shobhitsinha04/battlebot/hardware/battlebot.kicad_pcb

## KiCad design hardware/battlebot.kicad_pcb (2026-09-28)

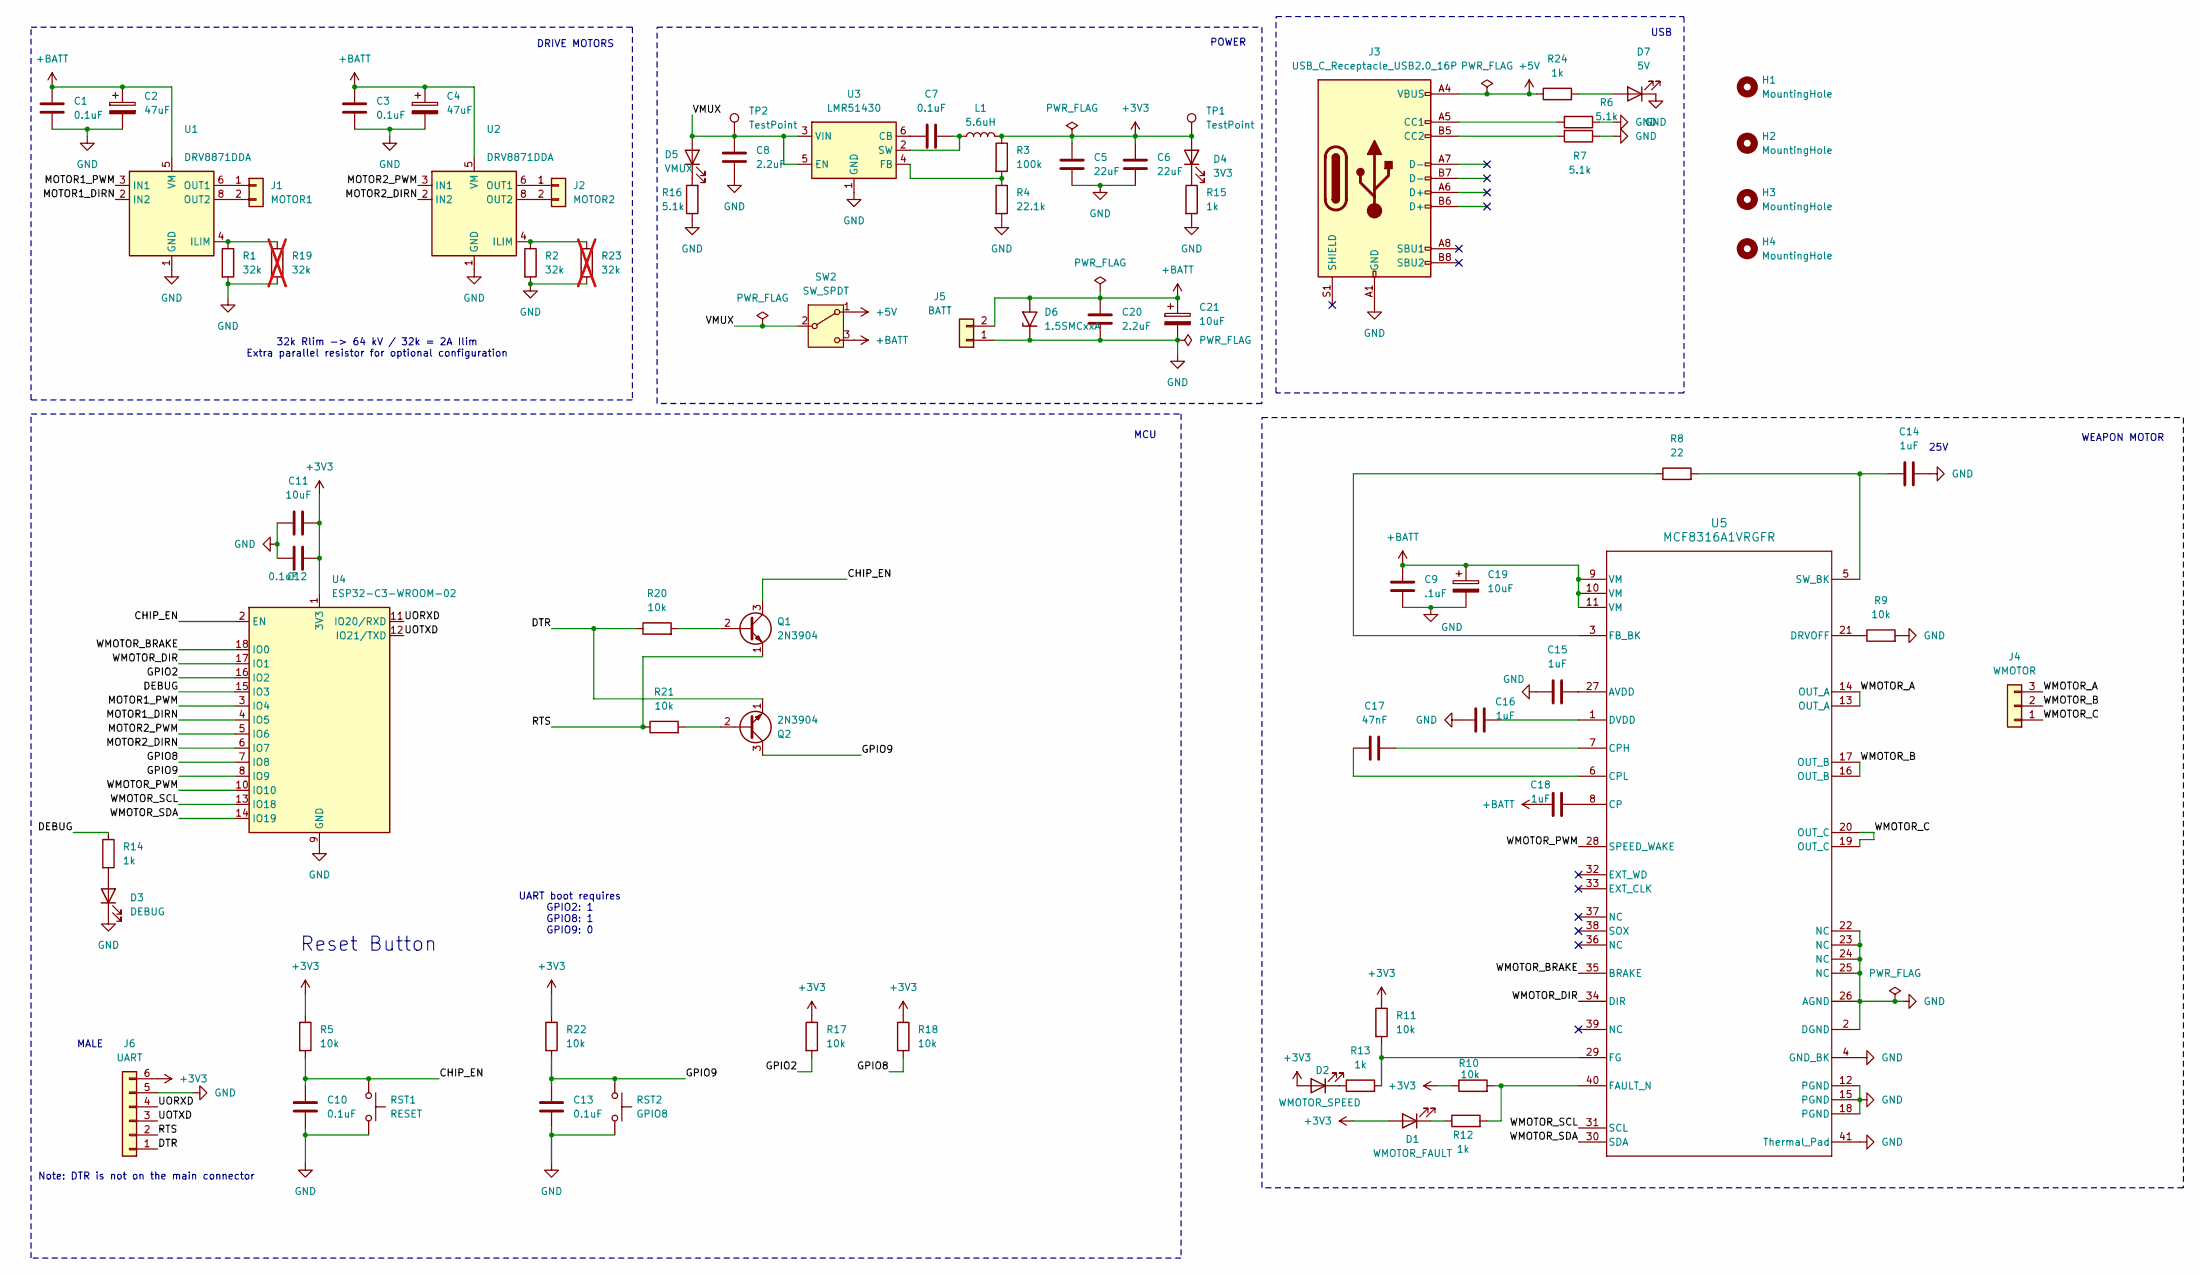
[picture p2: schematic battlebot.kicad_sch]

Parts:
C1, C3, C7, C10, C12, C13: 0.1uF; C_0805_2012Metric
C2, C4: 47uF; CP_Radial_D8.0mm_P5.00mm
C5, C6: 22uF; C_0805_2012Metric
C8, C20: 2.2uF; C_0805_2012Metric
C9: .1uF; C_0805_2012Metric
C11: 10uF; C_0805_2012Metric
C14, C15, C16, C18: 1uF; C_0805_2012Metric
C17: 47nF; C_0805_2012Metric
C19, C21: 10uF; CP_Radial_D8.0mm_P5.00mm
D1: WMOTOR_FAULT; C_0805_2012Metric
D2: WMOTOR_SPEED; C_0805_2012Metric
D3: DEBUG; C_0805_2012Metric
D4: 3V3; C_0805_2012Metric
D5: VMUX; C_0805_2012Metric
D6: 1.5SMCxxA; D_SMC
D7: 5V; C_0805_2012Metric
H1, H2, H3, H4: MountingHole; MountingHole_2.2mm_M2
J1: MOTOR1; PinSocket_1x02_P2.54mm_Vertical
J2: MOTOR2; PinSocket_1x02_P2.54mm_Vertical
J3: USB_C_Receptacle_USB2.0_16P; USB_C_Receptacle_G-Switch_GT-USB-7010ASV
J4: WMOTOR; PinHeader_1x03_P2.54mm_Vertical
J5: BATT; PinHeader_1x02_P2.54mm_Vertical
J6: UART; PinHeader_1x06_P2.54mm_Vertical
L1: 5.6uH; L_0805_2012Metric
Q1, Q2: 2N3904; TO-92_Inline
R1, R2: 32k; R_0805_2012Metric
R3: 100k; R_0805_2012Metric
R4: 22.1k; R_0805_2012Metric
R5, R9, R10, R11, R17, R18, R20, R21, R22: 10k; R_0805_2012Metric
R6, R7, R16: 5.1k; R_0805_2012Metric
R8: 22; R_0805_2012Metric
R12, R13, R14, R15, R24: 1k; R_0805_2012Metric
R19, R23: 32k; R_0805_2012Metric; not fitted
RST1: RESET; SW_TH_Tactile_Omron_B3F-100x
RST2: GPIO8; SW_TH_Tactile_Omron_B3F-100x
SW2: SW_SPDT; SW_SPDT_CK_JS102011SAQN
TP1, TP2: TestPoint
U1, U2: DRV8871DDA; Texas_HTSOP-8-1EP_3.9x4.9mm_P1.27mm_EP2.95x4.9mm_Mask2.4x3.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
U3: LMR51430; SOT-23-6
U4: ESP32-C3-WROOM-02; ESP32-C3-WROOM-02U
U5: MCF8316A1VRGFR; RGF0040E-IPC_A

Connections:
+3V3: C5.1, C6.1, C11.1, C12.1, D1.2 (A), D2.2 (A), D4.2 (A), J6.6, L1.2, R3.1, R5.1, R10.1, R11.1, R17.1, R18.1, R22.1, TP1.1, U4.1 (3V3)
+5V: J3.A4 (VBUS), J3.A9 (VBUS), J3.B4 (VBUS), J3.B9 (VBUS), R24.1, SW2.1 (A)
+BATT: C1.1, C2.1, C3.1, C4.1, C9.1, C18.1, C19.1, C20.1, C21.1, D6.2 (A2), J5.2, SW2.3 (C), U1.5 (VM), U2.5 (VM), U5.9 (VM), U5.10 (VM), U5.11 (VM)
/CHIP_EN: C10.1, Q1.3 (C), R5.2, RST1.1, U4.2 (EN)
/DEBUG: R14.1, U4.15 (IO3)
/DTR: J6.1, Q2.1 (E), R20.1
/GPIO2: R17.2, U4.16 (IO2)
/GPIO8: R18.2, U4.7 (IO8)
/GPIO9: C13.1, Q2.3 (C), R22.2, RST2.1, U4.8 (IO9)
/MOTOR1_DIRN: U1.2 (IN2), U4.4 (IO5)
/MOTOR1_PWM: U1.3 (IN1), U4.3 (IO4)
/MOTOR2_DIRN: U2.2 (IN2), U4.6 (IO7)
/MOTOR2_PWM: U2.3 (IN1), U4.5 (IO6)
/RTS: J6.2, Q1.1 (E), R21.1
/UORXD: J6.4, U4.11 (IO20/RXD)
/UOTXD: J6.3, U4.12 (IO21/TXD)
/VMUX: C8.1, D5.2 (A), SW2.2 (B), TP2.1, U3.3 (VIN), U3.5 (EN)
/WMOTOR_A: J4.3, U5.13 (OUT_A), U5.14 (OUT_A)
/WMOTOR_B: J4.2, U5.16 (OUT_B), U5.17 (OUT_B)
/WMOTOR_BRAKE: U4.18 (IO0), U5.35 (BRAKE)
/WMOTOR_C: J4.1, U5.19 (OUT_C), U5.20 (OUT_C)
/WMOTOR_DIR: U4.17 (IO1), U5.34 (DIR)
/WMOTOR_PWM: U4.10 (IO10), U5.28 (SPEED_WAKE)
/WMOTOR_SCL: U4.13 (IO18), U5.31 (SCL)
/WMOTOR_SDA: U4.14 (IO19), U5.30 (SDA)
GND: C1.2, C2.2, C3.2, C4.2, C5.2, C6.2, C8.2, C9.2, C10.2, C11.2, C12.2, C13.2, C14.2, C15.1, C16.1, C19.2, C20.2, C21.2, D3.1 (K), D6.1 (A1), D7.1 (K), J3.A1 (GND), J3.A12 (GND), J3.B1 (GND), J3.B12 (GND), J5.1, J6.5, R1.2, R2.2, R4.2, R6.1, R7.1, R9.2, R15.2, R16.1, R19.2, R23.2, RST1.2, RST2.2, U1.1 (GND), U1.7 (GND), U1.9 (GND), U2.1 (GND), U2.7 (GND), U2.9 (GND), U3.1 (GND), U4.9 (GND), U4.19 (GND), U5.2 (DGND), U5.4 (GND_BK), U5.12 (PGND), U5.15 (PGND), U5.18 (PGND), U5.22 (NC), U5.23 (NC), U5.24 (NC), U5.25 (NC), U5.26 (AGND), U5.41 (Thermal_Pad)
unnamed: D1.1 (K), R12.1
unnamed: D2.1 (K), R13.1
unnamed: D3.2 (A), R14.2
unnamed: D4.1 (K), R15.1
unnamed: D5.1 (K), R16.2
unnamed: D7.2 (A), R24.2
unnamed: J1.1, U1.6 (OUT1)
unnamed: J1.2, U1.8 (OUT2)
unnamed: J2.1, U2.6 (OUT1)
unnamed: J2.2, U2.8 (OUT2)
unnamed: J3.A5 (CC1), R6.2
unnamed: J3.B5 (CC2), R7.2
unnamed: Q1.2 (B), R20.2
unnamed: Q2.2 (B), R21.2
unnamed: R1.1, R19.1, U1.4 (ILIM)
unnamed: R2.1, R23.1, U2.4 (ILIM)
unnamed: C7.2, U3.6 (CB)
unnamed: R3.2, R4.1, U3.4 (FB)
unnamed: C7.1, L1.1, U3.2 (SW)
unnamed: C15.2, U5.27 (AVDD)
unnamed: C18.2, U5.8 (CP)
unnamed: C17.2, U5.7 (CPH)
unnamed: C17.1, U5.6 (CPL)
unnamed: R9.1, U5.21 (DRVOFF)
unnamed: C16.2, U5.1 (DVDD)
unnamed: R10.2, R12.2, U5.40 (FAULT_N)
unnamed: R8.1, U5.3 (FB_BK)
unnamed: R11.2, R13.2, U5.29 (FG)
unnamed: C14.1, R8.2, U5.5 (SW_BK)

Notes on the sheet:
MALE
WEAPON MOTOR
Reset Button
POWER
USB
UART boot requires GPIO2: 1 GPIO8: 1 GPIO9: 0
DRIVE MOTORS
25V
MCU
32k Rlim -> 64 kV / 32k = 2A Ilim Extra parallel resistor for optional configuration
Note: DTR is not on the main connector

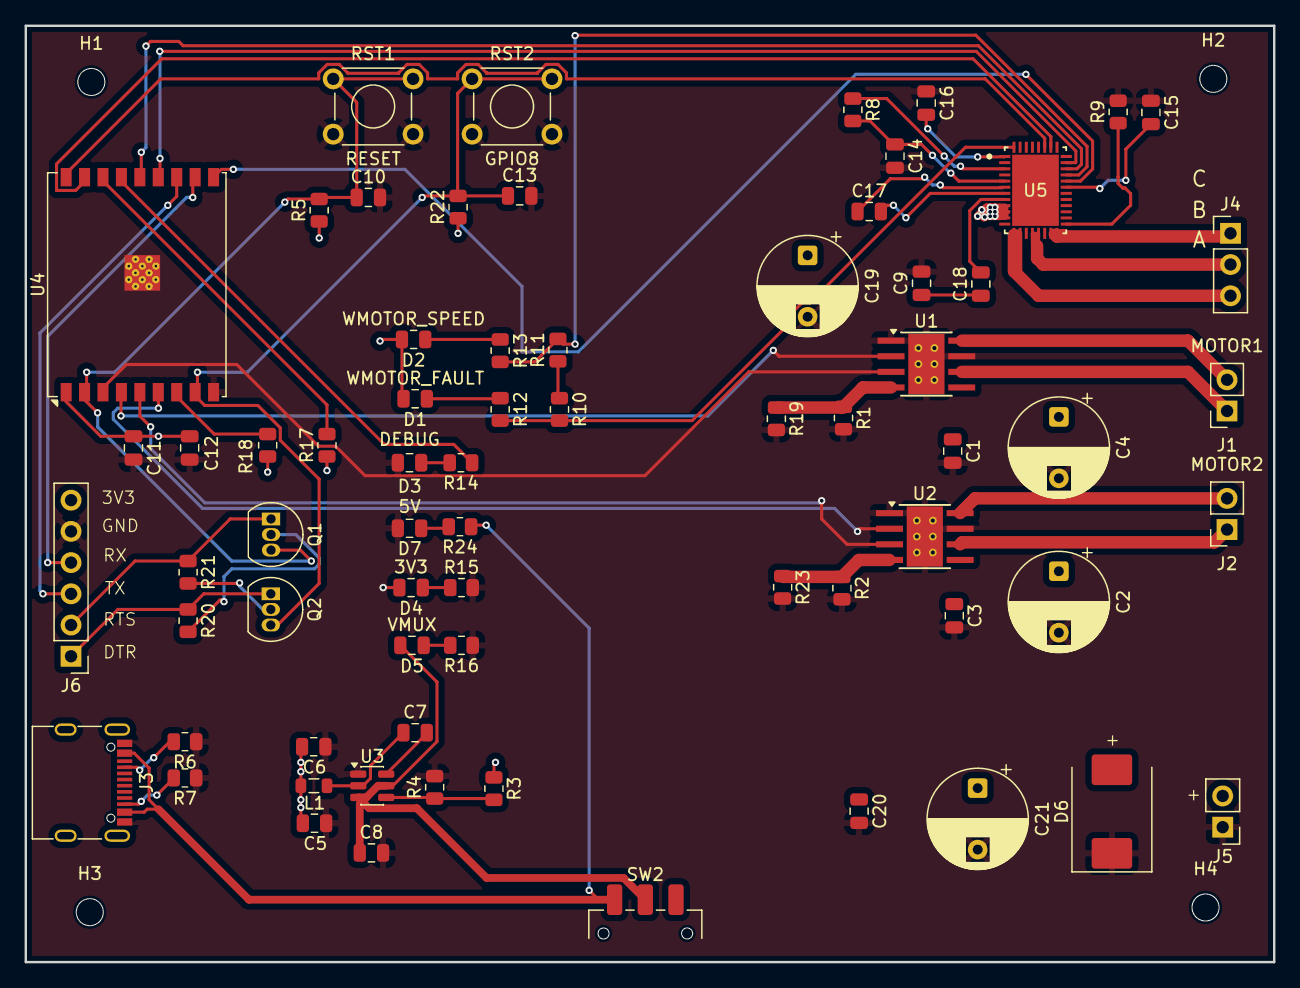
[picture p3: board battlebot.kicad_pcb from above]

Board: 2 copper layers, 101.6 x 76.2 mm, 73 parts (0 on the bottom side), 55 nets.
